qiaoyinzheng/performingrobots/Reminder.md

# Remember to Charge it on Monday night, the battery should be on when it's charging
## To do
Motors
Balance
Costume
always turn on the battery on the bottom for all pins connected to the shield(16-21)
battery ON when charging
