qiaoyinzheng/performingrobots/(commit log)

2025-10-22 try to add arm
2025-10-29 Update to add sample code
2025-11-07 Add reminder notes for battery and tasks
2025-11-24 Update according to prof’s list
2025-12-13 Reorganize battery reminder notes in Reminder.md
2025-12-13 Final Code After Show
    For future robot people:
    1. The RC sometimes sent opposite signals for forward and reverse, so we prepared 2 codes for both situations.
    2. The /* comment didn't work well with our long color code, so we cannot follow Prof's instruction to include in the same file.
    [TransmitterReceiverCode.ino, Transmitter_nov22.ino, hobbycode_nov20.ino, manual_reversed_hobby_dec_6.ino]
